cesaraz455/auxi/docs/auxi_pcb_3d_iso.png

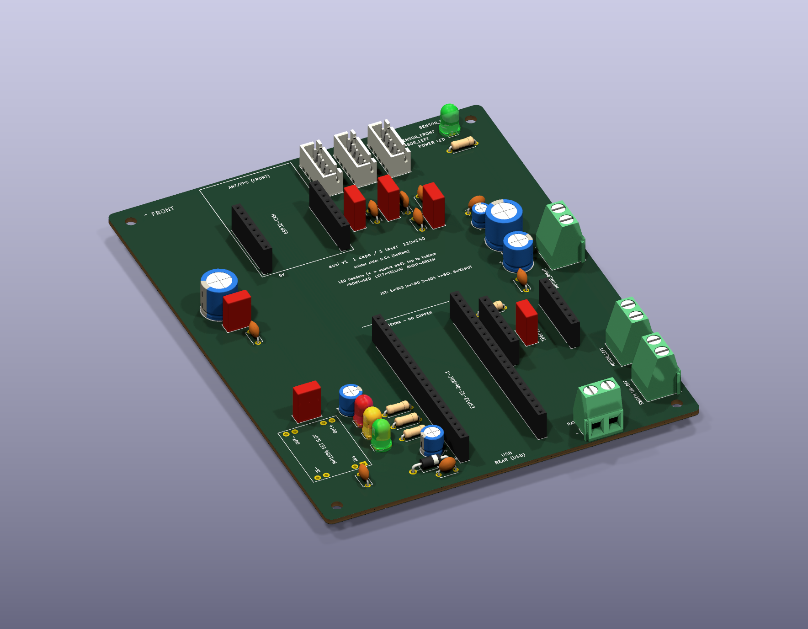
docs/auxi_pcb_3d_iso.png
