cesaraz455/auxi/docs/auxi_pcb_3d_top.png

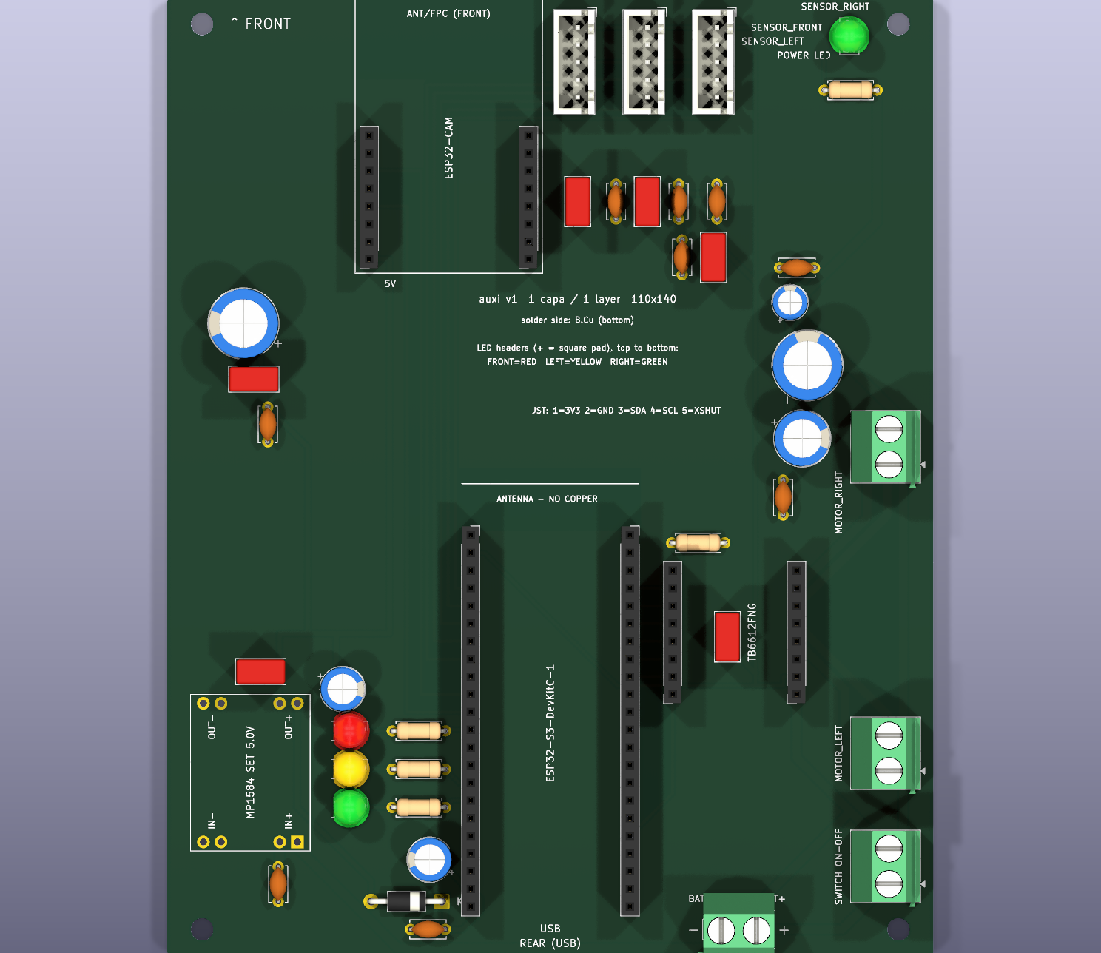
docs/auxi_pcb_3d_top.png
