cesaraz455/auxi/docs/auxi_pcb_bottom.png

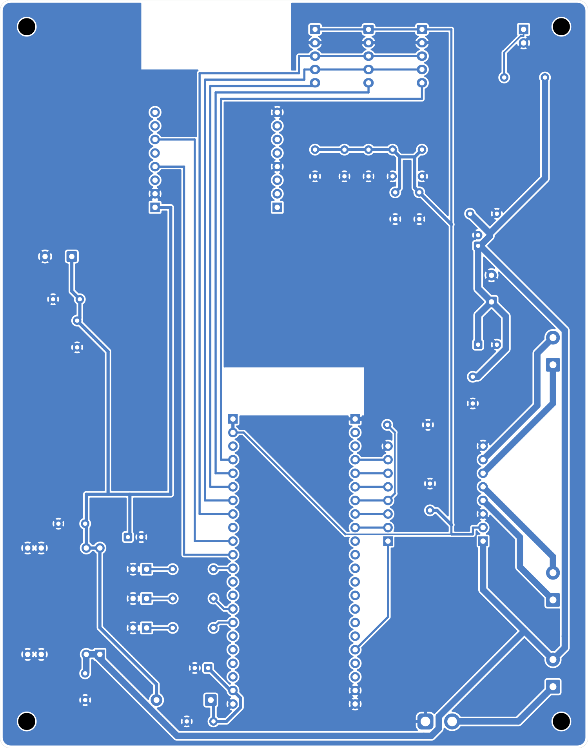
docs/auxi_pcb_bottom.png
