cesaraz455/auxi/docs/auxi_pcb_placement.png

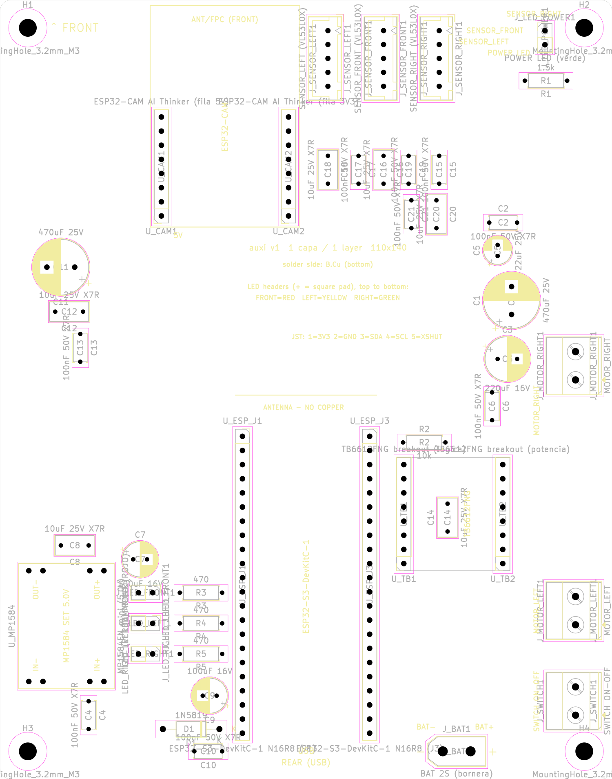
docs/auxi_pcb_placement.png
