cesaraz455/auxi/docs/auxi_pcb_top.png

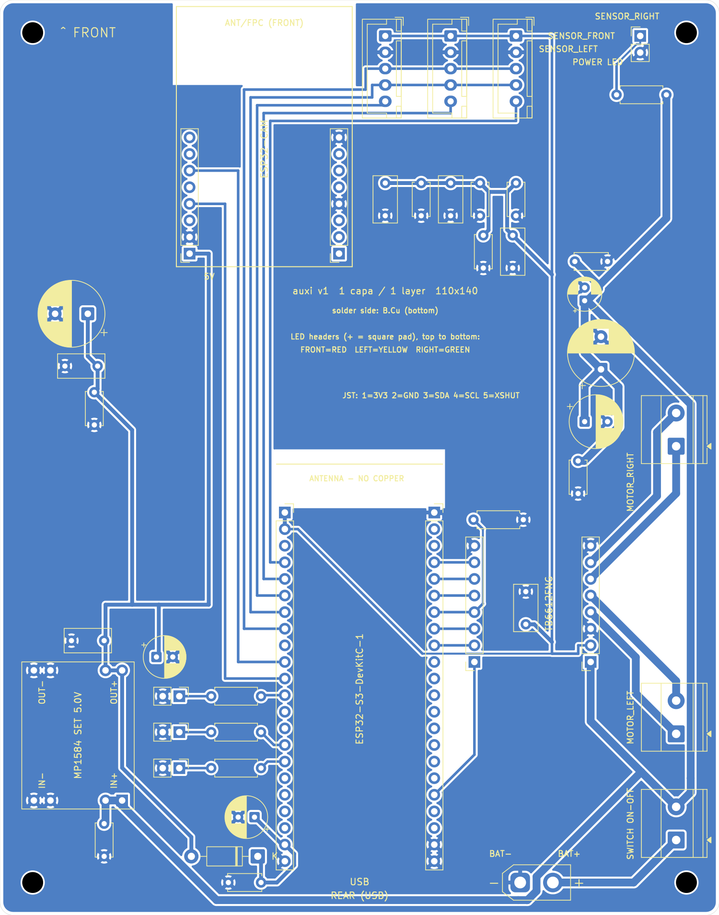
docs/auxi_pcb_top.png
