cesaraz455/auxi/docs/auxi_bom_pcb.csv

Referencias | Valor | Footprint | Cantidad | DNP
C1,C11 | 470uF 25V | Capacitor_THT:CP_Radial_D10.0mm_P5.00mm | 2
C2,C4,C6,C10,C13,C15,C17,C19,C21 | 100nF 50V X7R | Capacitor_THT:C_Disc_D5.0mm_W2.5mm_P5.00mm | 9
C3 | 220uF 16V | Capacitor_THT:CP_Radial_D8.0mm_P3.50mm | 1
C5 | 22uF 25V | Capacitor_THT:CP_Radial_D5.0mm_P2.00mm | 1
C7,C9 | 100uF 16V | Capacitor_THT:CP_Radial_D6.3mm_P2.50mm | 2
C8,C12,C14,C16,C18,C20 | 10uF 25V X7R | Capacitor_THT:C_Rect_L7.0mm_W3.5mm_P5.00mm | 6
D1 | 1N5819 | Diode_THT:D_DO-41_SOD81_P10.16mm_Horizontal | 1
J_BAT1 | BAT 2S (bornera) | Connector_AMASS:AMASS_XT30UPB-M_1x02_P5.0mm_Vertical | 1
J_LED_FRONT1 | LED_FRONT (ROJO) | auxi:PinHeader_1x02_P2.54mm_Vertical | 1
J_LED_LEFT1 | LED_LEFT (AMARILLO) | auxi:PinHeader_1x02_P2.54mm_Vertical | 1
J_LED_POWER1 | POWER LED (verde) | auxi:PinHeader_1x02_P2.54mm_Vertical | 1
J_LED_RIGHT1 | LED_RIGHT (VERDE) | auxi:PinHeader_1x02_P2.54mm_Vertical | 1
J_MOTOR_LEFT1 | MOTOR_LEFT | TerminalBlock_Phoenix:TerminalBlock_Phoenix_MKDS-1,5-2-5.08_1x02_P5.08mm_Horizontal | 1
J_MOTOR_RIGHT1 | MOTOR_RIGHT | TerminalBlock_Phoenix:TerminalBlock_Phoenix_MKDS-1,5-2-5.08_1x02_P5.08mm_Horizontal | 1
J_SENSOR_FRONT1 | SENSOR_FRONT (VL53L0X) | auxi:JST_XH_B5B-XH-A_1x05_P2.50mm_Vertical | 1
J_SENSOR_LEFT1 | SENSOR_LEFT (VL53L0X) | auxi:JST_XH_B5B-XH-A_1x05_P2.50mm_Vertical | 1
J_SENSOR_RIGHT1 | SENSOR_RIGHT (VL53L0X) | auxi:JST_XH_B5B-XH-A_1x05_P2.50mm_Vertical | 1
J_SWITCH1 | SWITCH ON-OFF | TerminalBlock_Phoenix:TerminalBlock_Phoenix_MKDS-1,5-2-5.08_1x02_P5.08mm_Horizontal | 1
R1 | 1.5k | Resistor_THT:R_Axial_DIN0207_L6.3mm_D2.5mm_P7.62mm_Horizontal | 1
R2 | 10k | Resistor_THT:R_Axial_DIN0207_L6.3mm_D2.5mm_P7.62mm_Horizontal | 1
R3-R5 | 470 | Resistor_THT:R_Axial_DIN0207_L6.3mm_D2.5mm_P7.62mm_Horizontal | 3
U_CAM1 | ESP32-CAM AI Thinker (fila 5V) | auxi:PinSocket_1x08_P2.54mm_Vertical | 1
U_CAM2 | ESP32-CAM AI Thinker (fila 3V3) | auxi:PinSocket_1x08_P2.54mm_Vertical | 1
U_ESP_J1 | ESP32-S3-DevKitC-1 N16R8 (J1) | auxi:PinSocket_1x22_P2.54mm_Vertical | 1
U_ESP_J3 | ESP32-S3-DevKitC-1 N16R8 (J3) | auxi:PinSocket_1x22_P2.54mm_Vertical | 1
U_MP1584 | MP1584EN mini (5.0V) | auxi:MP1584_Mini_PROVISIONAL | 1
U_TB1 | TB6612FNG breakout (logica) | auxi:PinSocket_1x08_P2.54mm_Vertical | 1
U_TB2 | TB6612FNG breakout (potencia) | auxi:PinSocket_1x08_P2.54mm_Vertical | 1
