cesaraz455/auxi/docs/auxi_pcb_real_scale.pdf

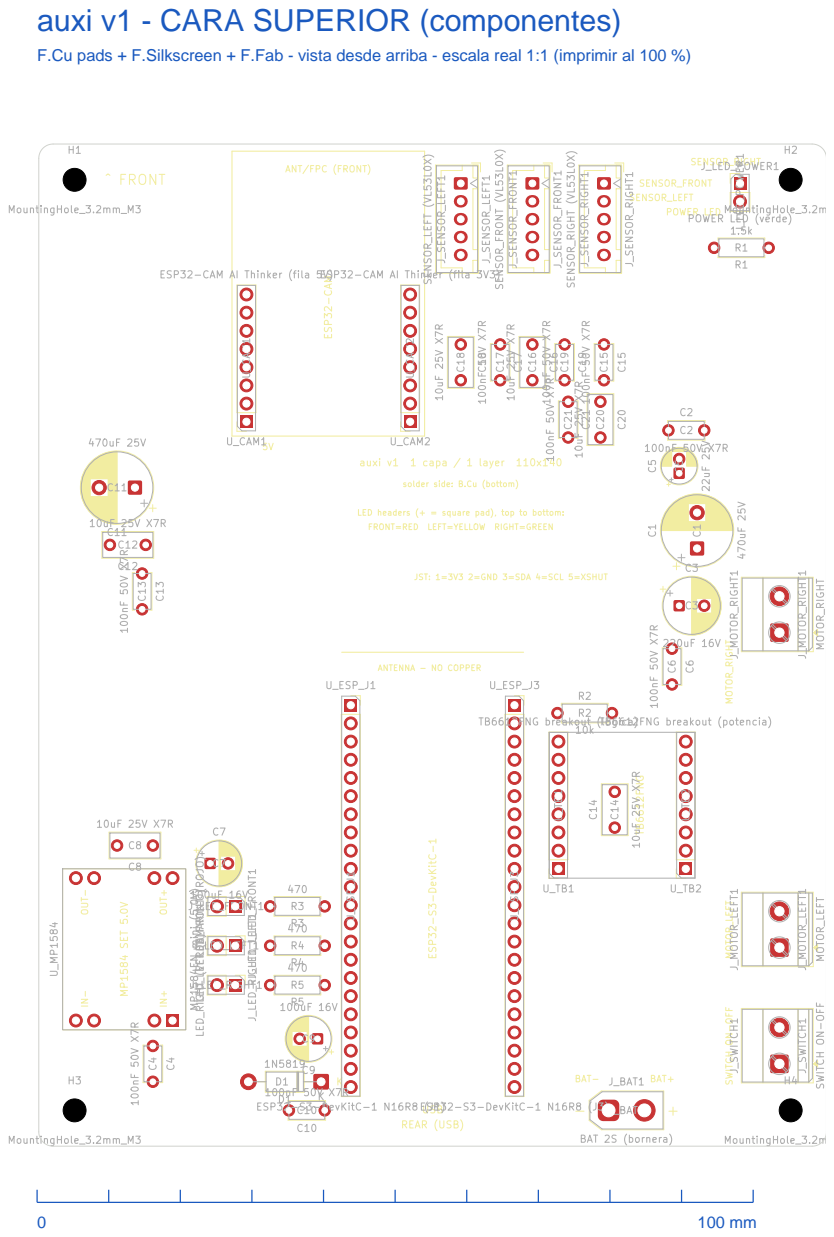
[picture p7: page 1]

auxi v1 - CARA SUPERIOR (componentes)
SENSOR_RIGHT MOTOR_RIGHT MOTOR_LEFT SWITCH ON-OFF USB
ESP32-CAM AI Thinker (fila 5V) U_CAM1 C8

F.Cu pads + F.Silkscreen + F.Fab - vista desde arriba - escala real 1:1 (imprimir al 100 %)

ESP32-CAM AI Thinker (fila 3V3) U_CAM2 C7

JST: 1=3V3 2=GND 3=SDA 4=SCL 5=XSHUT 5V

solder side: B.Cu (bottom) LED headers (+ = square pad), top to bottom: FRONT=RED LEFT=YELLOW RIGHT=GREEN

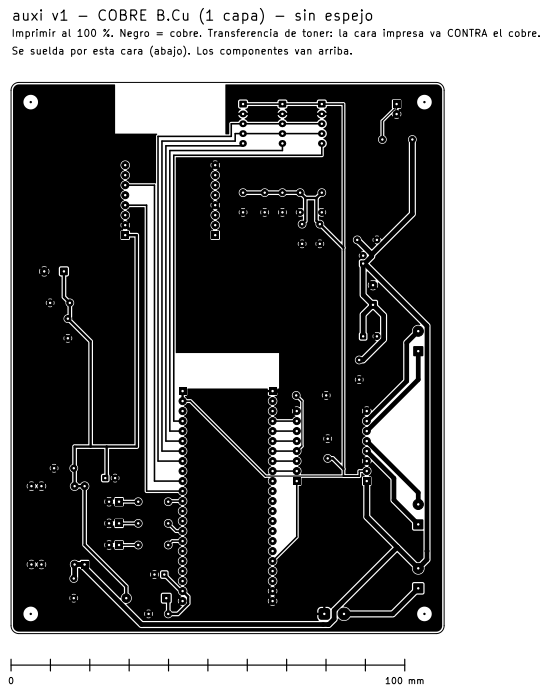
[picture p8: page 2]

auxi v1 - COBRE B.Cu (1 capa) - sin espejo
Imprimir al 100 %. Negro = cobre. Transferencia de toner: la cara impresa va CONTRA el cobre.
Se suelda por esta cara (abajo). Los componentes van arriba.

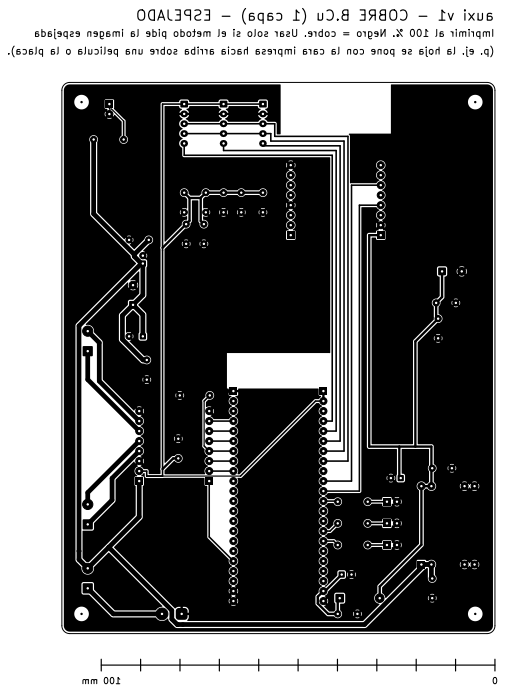
[picture p9: page 3]

ESPEJADO - capa) (1 B.Cu COBRE - v1 auxi

espejada imagen la pide metodo el si solo Usar cobre. = Negro %. 100 al Imprimir

placa). la o pelicula una sobre arriba hacia impresa cara la con pone se hoja la ej. (p.
