cesaraz455/auxi/auxi.kicad_pcb

## KiCad design auxi.kicad_pcb (2026-10-31)

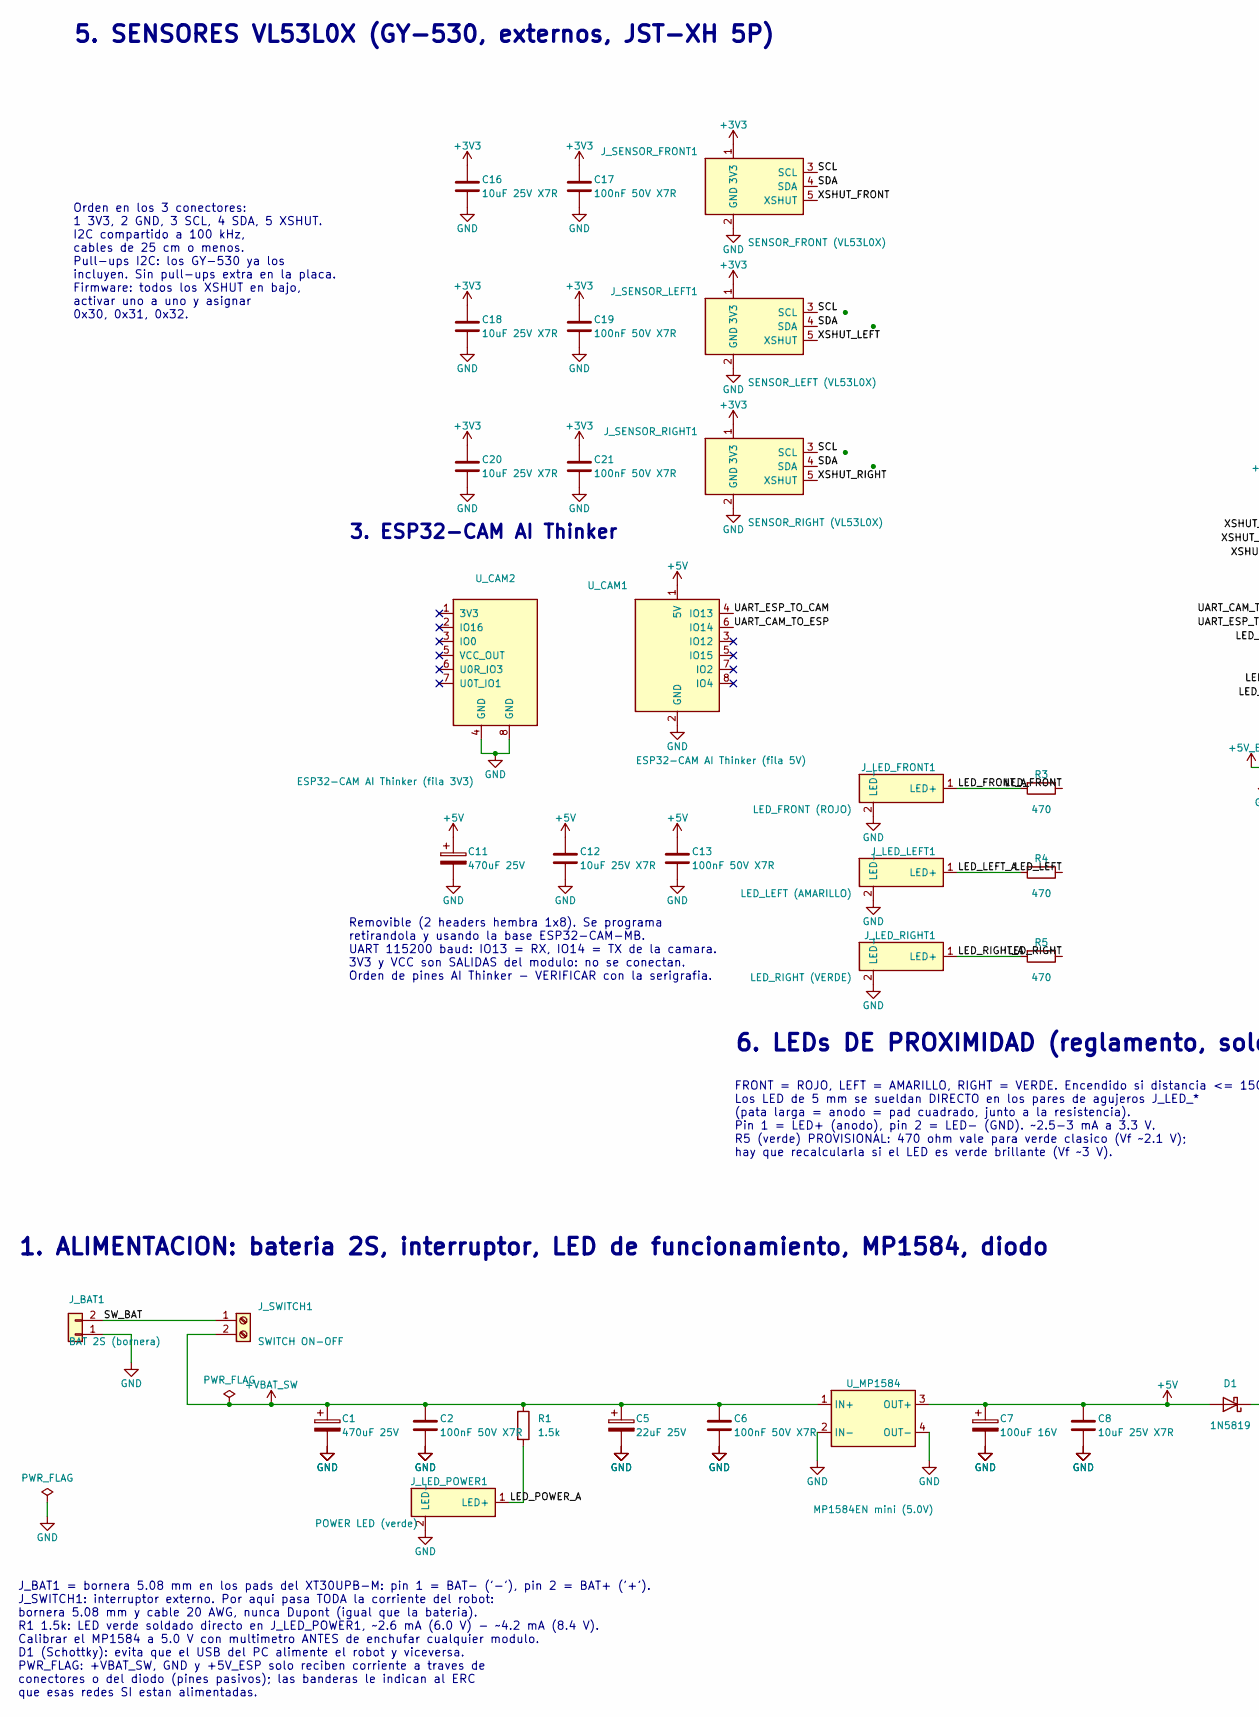
[picture p10: schematic auxi.kicad_sch, auxi - robot futbolero, part in row 1, column 1]

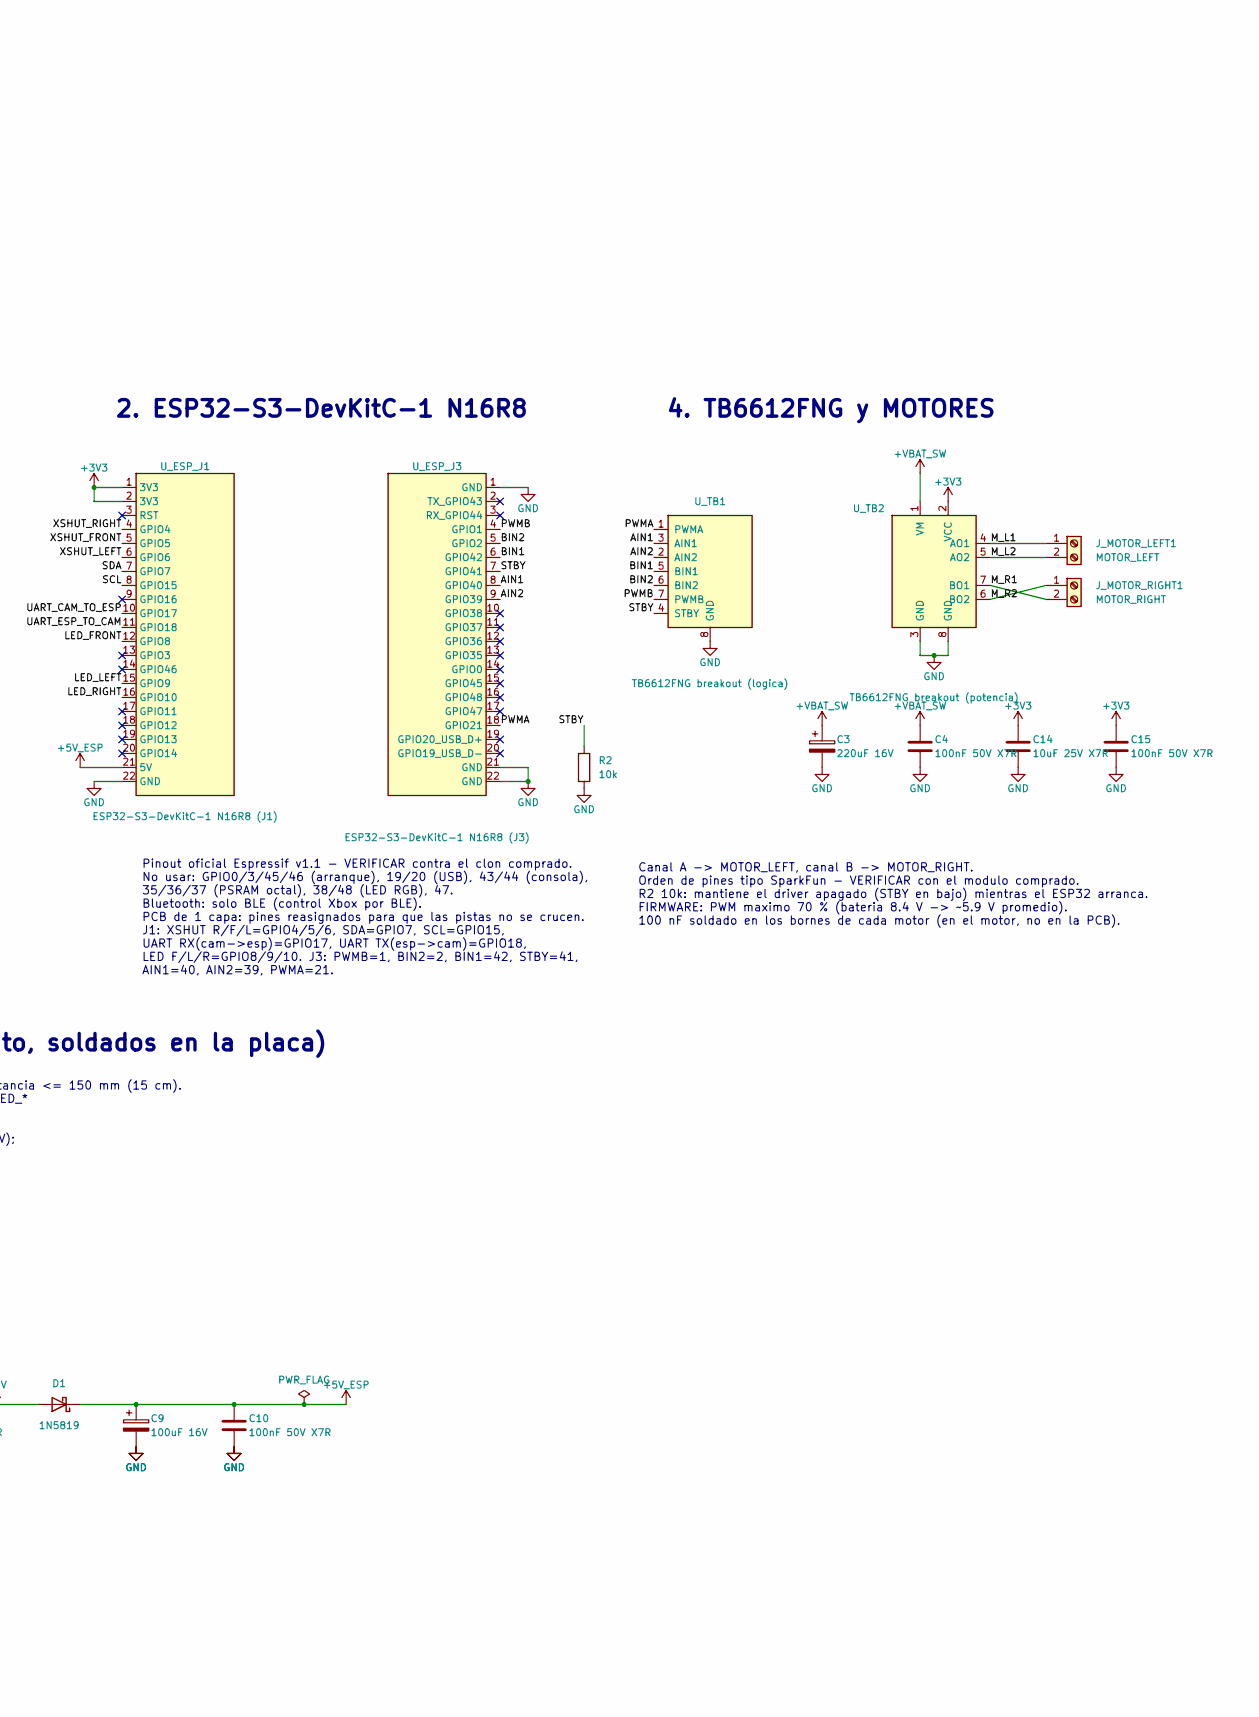
[picture p11: schematic auxi.kicad_sch, auxi - robot futbolero, part in row 1, column 2]

Parts:
C1, C11: 470uF 25V; CP_Radial_D10.0mm_P5.00mm
C2, C4, C6, C10, C13, C15, C17, C19, C21: 100nF 50V X7R; C_Disc_D5.0mm_W2.5mm_P5.00mm
C3: 220uF 16V; CP_Radial_D8.0mm_P3.50mm
C5: 22uF 25V; CP_Radial_D5.0mm_P2.00mm
C7, C9: 100uF 16V; CP_Radial_D6.3mm_P2.50mm
C8, C12, C14, C16, C18, C20: 10uF 25V X7R; C_Rect_L7.0mm_W3.5mm_P5.00mm
D1: 1N5819; D_DO-41_SOD81_P10.16mm_Horizontal
J_BAT1: BAT 2S (bornera); AMASS_XT30UPB-M_1x02_P5.0mm_Vertical
J_LED_FRONT1: LED_FRONT (ROJO); PinHeader_1x02_P2.54mm_Vertical
J_LED_LEFT1: LED_LEFT (AMARILLO); PinHeader_1x02_P2.54mm_Vertical
J_LED_POWER1: POWER LED (verde); PinHeader_1x02_P2.54mm_Vertical
J_LED_RIGHT1: LED_RIGHT (VERDE); PinHeader_1x02_P2.54mm_Vertical
J_MOTOR_LEFT1: MOTOR_LEFT; TerminalBlock_Phoenix_MKDS-1,5-2-5.08_1x02_P5.08mm_Horizont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
J_MOTOR_RIGHT1: MOTOR_RIGHT; TerminalBlock_Phoenix_MKDS-1,5-2-5.08_1x02_P5.08mm_Horizont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
J_SENSOR_FRONT1: SENSOR_FRONT (VL53L0X); JST_XH_B5B-XH-A_1x05_P2.50mm_Vertical
J_SENSOR_LEFT1: SENSOR_LEFT (VL53L0X); JST_XH_B5B-XH-A_1x05_P2.50mm_Vertical
J_SENSOR_RIGHT1: SENSOR_RIGHT (VL53L0X); JST_XH_B5B-XH-A_1x05_P2.50mm_Vertical
J_SWITCH1: SWITCH ON-OFF; TerminalBlock_Phoenix_MKDS-1,5-2-5.08_1x02_P5.08mm_Horizont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
R1: 1.5k; R_Axial_DIN0207_L6.3mm_D2.5mm_P7.62mm_Horizontal
R2: 10k; R_Axial_DIN0207_L6.3mm_D2.5mm_P7.62mm_Horizontal
R3, R4, R5: 470; R_Axial_DIN0207_L6.3mm_D2.5mm_P7.62mm_Horizontal
U_CAM1: ESP32-CAM AI Thinker (fila 5V); PinSocket_1x08_P2.54mm_Vertical
U_CAM2: ESP32-CAM AI Thinker (fila 3V3); PinSocket_1x08_P2.54mm_Vertical
U_ESP_J1: ESP32-S3-DevKitC-1 N16R8 (J1); PinSocket_1x22_P2.54mm_Vertical
U_ESP_J3: ESP32-S3-DevKitC-1 N16R8 (J3); PinSocket_1x22_P2.54mm_Vertical
U_MP1584: MP1584EN mini (5.0V); MP1584_Mini_PROVISIONAL
U_TB1: TB6612FNG breakout (logica); PinSocket_1x08_P2.54mm_Vertical
U_TB2: TB6612FNG breakout (potencia); PinSocket_1x08_P2.54mm_Vertical

Connections:
+3V3: C14.1, C15.1, C16.1, C17.1, C18.1, C19.1, C20.1, C21.1, J_SENSOR_FRONT1.1 (3V3), J_SENSOR_LEFT1.1 (3V3), J_SENSOR_RIGHT1.1 (3V3), U_ESP_J1.1 (3V3), U_ESP_J1.2 (3V3), U_TB2.2 (VCC)
+5V: C7.1, C8.1, C11.1, C12.1, C13.1, D1.2 (A), U_CAM1.1 (5V), U_MP1584.3 (OUT+)
+5V_ESP: C9.1, C10.1, D1.1 (K), U_ESP_J1.21 (5V)
+VBAT_SW: C1.1, C2.1, C3.1, C4.1, C5.1, C6.1, J_SWITCH1.2, R1.1, U_MP1584.1 (IN+), U_TB2.1 (VM)
AIN1: U_ESP_J3.8 (GPIO40), U_TB1.3 (AIN1)
AIN2: U_ESP_J3.9 (GPIO39), U_TB1.2 (AIN2)
BIN1: U_ESP_J3.6 (GPIO42), U_TB1.5 (BIN1)
BIN2: U_ESP_J3.5 (GPIO2), U_TB1.6 (BIN2)
GND: C1.2, C2.2, C3.2, C4.2, C5.2, C6.2, C7.2, C8.2, C9.2, C10.2, C11.2, C12.2, C13.2, C14.2, C15.2, C16.2, C17.2, C18.2, C19.2, C20.2, C21.2, J_BAT1.1, J_LED_FRONT1.2 (LED-), J_LED_LEFT1.2 (LED-), J_LED_POWER1.2 (LED-), J_LED_RIGHT1.2 (LED-), J_SENSOR_FRONT1.2 (GND), J_SENSOR_LEFT1.2 (GND), J_SENSOR_RIGHT1.2 (GND), R2.2, U_CAM1.2 (GND), U_CAM2.4 (GND), U_CAM2.8 (GND), U_ESP_J1.22 (GND), U_ESP_J3.1 (GND), U_ESP_J3.21 (GND), U_ESP_J3.22 (GND), U_MP1584.2 (IN-), U_MP1584.4 (OUT-), U_TB1.8 (GND), U_TB2.3 (GND), U_TB2.8 (GND)
LED_FRONT: R3.1, U_ESP_J1.12 (GPIO8)
LED_FRONT_A: J_LED_FRONT1.1 (LED+), R3.2
LED_LEFT: R4.1, U_ESP_J1.15 (GPIO9)
LED_LEFT_A: J_LED_LEFT1.1 (LED+), R4.2
LED_POWER_A: J_LED_POWER1.1 (LED+), R1.2
LED_RIGHT: R5.1, U_ESP_J1.16 (GPIO10)
LED_RIGHT_A: J_LED_RIGHT1.1 (LED+), R5.2
M_L1: J_MOTOR_LEFT1.1, U_TB2.4 (AO1)
M_L2: J_MOTOR_LEFT1.2, U_TB2.5 (AO2)
M_R1: J_MOTOR_RIGHT1.2, U_TB2.7 (BO1)
M_R2: J_MOTOR_RIGHT1.1, U_TB2.6 (BO2)
PWMA: U_ESP_J3.18 (GPIO21), U_TB1.1 (PWMA)
PWMB: U_ESP_J3.4 (GPIO1), U_TB1.7 (PWMB)
SCL: J_SENSOR_FRONT1.3 (SCL), J_SENSOR_LEFT1.3 (SCL), J_SENSOR_RIGHT1.3 (SCL), U_ESP_J1.8 (GPIO15)
SDA: J_SENSOR_FRONT1.4 (SDA), J_SENSOR_LEFT1.4 (SDA), J_SENSOR_RIGHT1.4 (SDA), U_ESP_J1.7 (GPIO7)
STBY: R2.1, U_ESP_J3.7 (GPIO41), U_TB1.4 (STBY)
SW_BAT: J_BAT1.2, J_SWITCH1.1
UART_CAM_TO_ESP: U_CAM1.6 (IO14), U_ESP_J1.10 (GPIO17)
UART_ESP_TO_CAM: U_CAM1.4 (IO13), U_ESP_J1.11 (GPIO18)
XSHUT_FRONT: J_SENSOR_FRONT1.5 (XSHUT), U_ESP_J1.5 (GPIO5)
XSHUT_LEFT: J_SENSOR_LEFT1.5 (XSHUT), U_ESP_J1.6 (GPIO6)
XSHUT_RIGHT: J_SENSOR_RIGHT1.5 (XSHUT), U_ESP_J1.4 (GPIO4)

Notes on the sheet:
1. ALIMENTACION: bateria 2S, interruptor, LED de funcionamiento, MP1584, diodo
J_BAT1 = bornera 5.08 mm en los pads del XT30UPB-M: pin 1 = BAT- ('-'), pin 2 = BAT+ ('+'). J_SWITCH1: interruptor externo. Por aqui pasa TODA la corriente del robot: bornera 5.08 mm y cable 20 AWG, nunca Dupont (igual que la bateria). R1 1.5k: LED verde soldado directo en J_LED_POWER1, ~2.6 mA (6.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
2. ESP32-S3-DevKitC-1 N16R8
Pinout oficial Espressif v1.1 - VERIFICAR contra el clon comprado. No usar: GPIO0/3/45/46 (arranque), 19/20 (USB), 43/44 (consola), 35/36/37 (PSRAM octal), 38/48 (LED RGB), 47. Bluetooth: solo BLE (control Xbox por BLE). PCB de 1 capa: pines reasignados para que las pistas no se crucen. J1: XSHUT R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
3. ESP32-CAM AI Thinker
Removible (2 headers hembra 1x8). Se programa retirandola y usando la base ESP32-CAM-MB. UART 115200 baud: IO13 = RX, IO14 = TX de la camara. 3V3 y VCC son SALIDAS del modulo: no se conectan. Orden de pines AI Thinker - VERIFICAR con la serigrafia.
4. TB6612FNG y MOTORES
Canal A -> MOTOR_LEFT, canal B -> MOTOR_RIGHT. Orden de pines tipo SparkFun - VERIFICAR con el modulo comprado. R2 10k: mantiene el driver apagado (STBY en bajo) mientras el ESP32 arranca. FIRMWARE: PWM maximo 70 % (bateria 8.4 V -> ~5.9 V promedio). 100 nF soldado en los bornes de cada motor (en e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
5. SENSORES VL53L0X (GY-530, externos, JST-XH 5P)
Orden en los 3 conectores: 1 3V3, 2 GND, 3 SCL, 4 SDA, 5 XSHUT. I2C compartido a 100 kHz, cables de 25 cm o menos. Pull-ups I2C: los GY-530 ya los incluyen. Sin pull-ups extra en la placa. Firmware: todos los XSHUT en bajo, activar uno a uno y asignar 0x30, 0x31, 0x32.
6. LEDs DE PROXIMIDAD (reglamento, soldados en la placa)
FRONT = ROJO, LEFT = AMARILLO, RIGHT = VERDE. Encendido si distancia <= 150 mm (15 cm). Los LED de 5 mm se sueldan DIRECTO en los pares de agujeros J_LED_* (pata larga = anodo = pad cuadrado, junto a la resistencia). Pin 1 = LED+ (anodo), pin 2 = LED- (GND). ~2.5-3 mA a 3.3 V. R5 (verde) PROVISIONA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

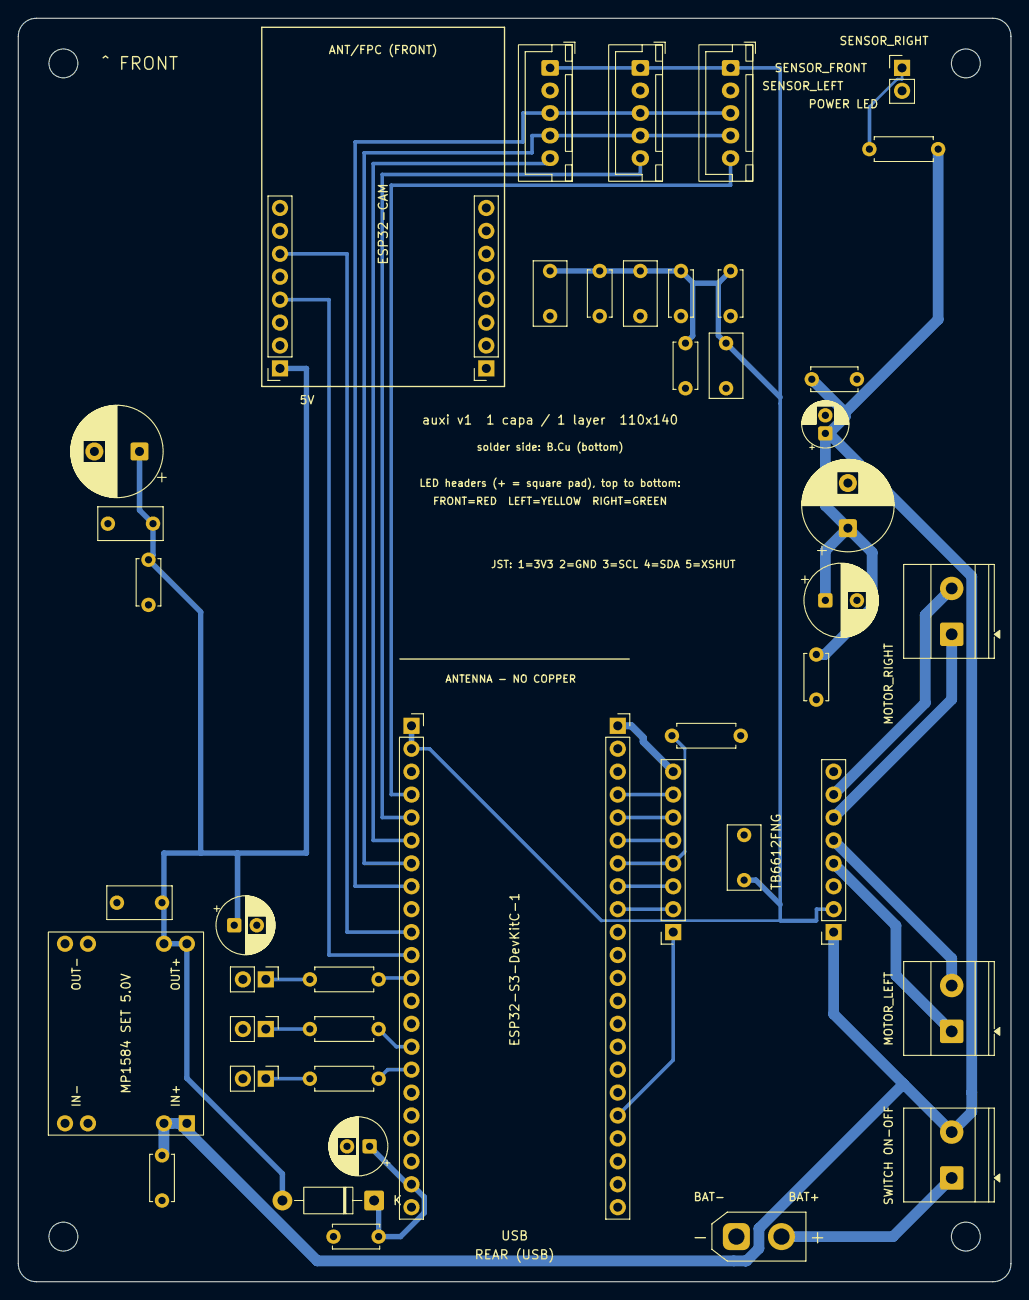
[picture p12: board auxi.kicad_pcb from above]

Board: 2 copper layers, 110.0 x 140.0 mm, 49 parts (0 on the bottom side), 31 nets.

Other parts of the board:
H1, H2, H3, H4: MountingHole_3.2mm_M3
