cesaraz455/auxi/(commit log)

2026-09-29 feat(sch): Schematic creation - add MP1584 Mini footprint and update BOM, schematic, and library tables
    - Created a new footprint for the MP1584 Mini module in the auxi.pretty library.
    - Added a new BOM (auxi_bom_pcb.csv) detailing components for the PCB design.
    - Included a new schematic PDF (auxi_esquematico.pdf) for the project.
    - Updated the footprint library table (fp-lib-table) to include the new auxi.pretty library.
    - Updated the symbol library table (sym-lib-table) to include the new auxi.kicad_sym library.
    [auxi.kicad_pcb, auxi.kicad_sch, auxi_bom_pcb.csv]
2026-09-29 feat(pcb): Add design settings, update schematic notes, and modify MP1584 module footprint
    - Introduced comprehensive design settings in `auxi.kicad_pro` for improved PCB layout control, including defaults for various design elements and DRC rules.
    - Updated schematic notes in `auxi.kicad_sch` to reflect changes in battery connector specifications and additional circuit details.
    - Enhanced the MP1584 module footprint in `MP1584_Mini_PROVISIONAL.kicad_mod` with corrected dimensions, improved pad layout, and updated silk screen labels for clarity.
    - Added a new PCB placement image `auxi_pcb_placement.png` to the documentation for better assembly guidance.
    [auxi.kicad_pcb, auxi.kicad_sch]
2026-10-07 Add initial DRC violations report, update BOM with correct footprints, modify schematic for clarity, and add PCB top image
    [auxi.kicad_pcb, auxi.kicad_sch, auxi_bom_pcb.csv]
2026-10-07 Refactor schematic and DRC violation files
    - Removed unnecessary wire segments from auxi.kicad_sch to clean up the schematic.
    - Added new wire connections to enhance circuit clarity in auxi.kicad_sch.
    - Updated timestamp in auxi_drc_violations.json to reflect the latest changes.
    - Added a new PDF document (auxi_pcb_real_scale.pdf) containing detailed PCB layouts for both top and bottom layers.
    [auxi.kicad_pcb, auxi.kicad_sch]
2026-10-15 feat(pcb): single-layer 110 x 140 mm board with GND pour, soldered from below
    Re-do the PCB as a one-copper-layer board for home etching and hand drilling:
    - Copper only on B.Cu with a GND pour; F.Cu has no copper (keepout over the
    whole top face). All parts are THT, mounted on top and soldered from below.
    No vias and no jumper wires: no two tracks cross.
    - Board outline 110 x 140 mm (was 90 x 100 mm), M3 holes 5 mm from the corners,
    antenna keepouts for the ESP32-S3 and the ESP32-CAM.
    - Track width >= 0.4 mm (0.3 mm only between pads / tight bundles), clearance
    0.2 mm, smallest hole 0.3 mm, default via 1.1 / 0.3 mm. Pad diameter = drill
    + 0.8 mm on every pad hole, enforced by aux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
    [auxi.kicad_pcb, auxi.kicad_sch, auxi_bom_pcb.csv]
2026-10-15 feat(pcb): spread the components over the whole board
    The first single-layer layout left the top third of the board empty and
    crowded the parts toward the bottom edge. The logic block (ESP32-S3, ESP32-CAM,
    TB6612FNG, MP1584) moves 26 mm north, the three sensor connectors get a 14 mm
    pitch, the power capacitors and the motor/LED connectors use the upper right
    corner, and the LED headers, big capacitors, diode, battery and switch are
    spaced along the bottom.
    - Re-routed on one layer: 224 tracks, 0 vias, no jumper wires.
    - DRC: 0 violations, 0 unconnected items. ERC clean. PCB nets match the
    schematic pin by pin. Pin mapping unchanged from the previous commit.
    - 55 tracks (377 mm) stay at 0.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
    [auxi.kicad_pcb]
2026-10-15 Move ESP32-S3 so its USB end sits ~5 mm from the board edge and re-route
    The USB port is now reachable from the side. The board was re-placed
    and re-routed on a single layer (199 tracks, DRC 0 violations, 0
    unconnected). J_LED_POWER moved off the corner so the +3V3 track can
    reach the TB6612 VCC pin. Docs, PDFs and renders regenerated.
    Claude-Session: https://claude.ai/code/session_01V1Casvb8MJmuQffuKiRczF
    [auxi.kicad_pcb]
2026-10-15 Re-layout for the real orientation: 110 mm side is the front, ESP32-S3 USB at the rear edge
    - ESP32-CAM at the front-left corner (camera looking forward), sensors
    along the front edge, ESP32-S3 at the rear with the USB end 1 mm from
    the edge, TB6612 and motor terminals on the east side, MP1584 on the
    west side.
    - GPIO mapping changed again: XSHUT 4/5/6, SCL 7, SDA 15, UART RX 17 and
    TX 18 (schematic labels updated, ERC clean, PCB nets match the schematic).
    - Board re-routed on one layer: 197 tracks, DRC 0 errors, 0 unconnected.
    - README, CLAUDE.md, PDFs, renders and DRC report regenerated.
    Claude-Session: https://claude.ai/co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
    [auxi.kicad_pcb, auxi.kicad_sch]
2026-10-15 Move the ESP32-CAM to the front (almost centered) and the sensors to its right
    The camera is now at x = 146.5 (14.5 mm left of the board centre) and the
    three sensor connectors sit to its right along the front edge. Camera
    UART/5V lanes and the sensor lines were laid out by hand, the rest by
    Freerouting. 167 tracks on one layer, DRC 0 errors, 0 unconnected; the PCB
    nets still match the schematic pin by pin. README, CLAUDE.md, PDFs and
    renders regenerated.
    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
    [auxi.kicad_pcb]
2026-10-27 Proximity LEDs soldered directly on the PCB; power LED is green
    - The three 5 mm proximity LEDs go straight into the J_LED_* hole pairs
    (right hole / square pad = anode). No header or Dupont jumpers for them.
    - Power LED is green (value, notes, BOM and docs updated; R1 1.5 kohm
    still valid: about 2.6 mA at 6.0 V and 4.2 mA at 8.4 V).
    - No copper change: ERC 0, DRC 0 errors / 0 unconnected.
    - README, CLAUDE.md, schematic notes, PDFs and BOM updated.
    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
    [auxi.kicad_pcb, auxi.kicad_sch, auxi_bom_pcb.csv]
2026-10-27 Docs: the robot has no enclosure, the board stays visible
    The proximity LEDs are visible by design, so no enclosure windows or
    clearances are needed. README.md and CLAUDE.md updated (new decision row,
    LED section, cable path, capacitor height, final checks, open items).
    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
2026-10-27 C3 (motor supply) is 220 uF 16 V instead of 25 V
    The rail is 8.4 V at most, so a 16 V part keeps a wide margin.
    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
    [auxi.kicad_pcb, auxi.kicad_sch, auxi_bom_pcb.csv]
2026-10-27 Chassis v8 update: LEDs soldered on the PCB, battery on a screw terminal
    PCB copper, footprints and tracks are unchanged. Updated the 3D models
    (colored 5 mm LEDs in auxi.3dshapes/, screw terminal for J_BAT1), the
    schematic descriptions and notes, CLAUDE.md and README.md.
    Work in progress: ERC/DRC and the regeneration of docs/*.pdf and *.png
    are still pending because kicad-cli was not available.
    Claude-Session: https://claude.ai/code/session_01HrZukSfyeMd8Be9PGS4Uge
    [auxi.kicad_pcb, auxi.kicad_sch, auxi_bom_pcb.csv]
2026-10-27 Regenerate docs, fix LED 3D models, add 3D renders
    - Fix the LED VRML models (KiCad drops a model with an ambientColor field).
    - Regenerate the schematic PDF, BOM, 2D renders, DRC report and page 1 of the 1:1 PDF.
    - Add 3D renders of the board.
    - Verified with KiCad 10.0.7: ERC 0 violations; DRC 0 errors, 0 unconnected,
    same single silkscreen warning as before.
    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
2026-10-27 Docs: number the sections, replace the section symbol, drop external document references
    - Replace every section symbol with 'Section N' and add a numbered contents table
    to CLAUDE.md and README.md.
    - Describe the printed chassis directly, without naming the external reference
    document, so the repository is self-contained.
    - Add a short explanation of what the robot is for to both documents.
    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
2026-10-31 Docs: proximity sensors are configured to turn on their LEDs at 15 cm
    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
    [auxi.kicad_sch]
2026-10-31 Docs: SDA=GPIO7 y SCL=GPIO15 segun el firmware; anotar rework pendiente de PCB
2026-10-31 KiCad: SDA=GPIO7 y SCL=GPIO15 segun el firmware
    Se renombran las redes SDA/SCL sin mover pistas. En los conectores de
    sensor el orden pasa a 3=SCL, 4=SDA.
    [auxi.kicad_pcb, auxi.kicad_sch]
2026-10-31 Docs: montaje espejo de la camara en los headers
    Claude-Session: https://claude.ai/code/session_01HrZukPSNFwLfAYGph4qWiV
